devramsean0/train-locs-board/README.md

# train-locs-board
A LED train location board, meant to show the trains on platform at any station
