devramsean0/train-locs-board/Journal/images/schematic-microcontroller-v1.png

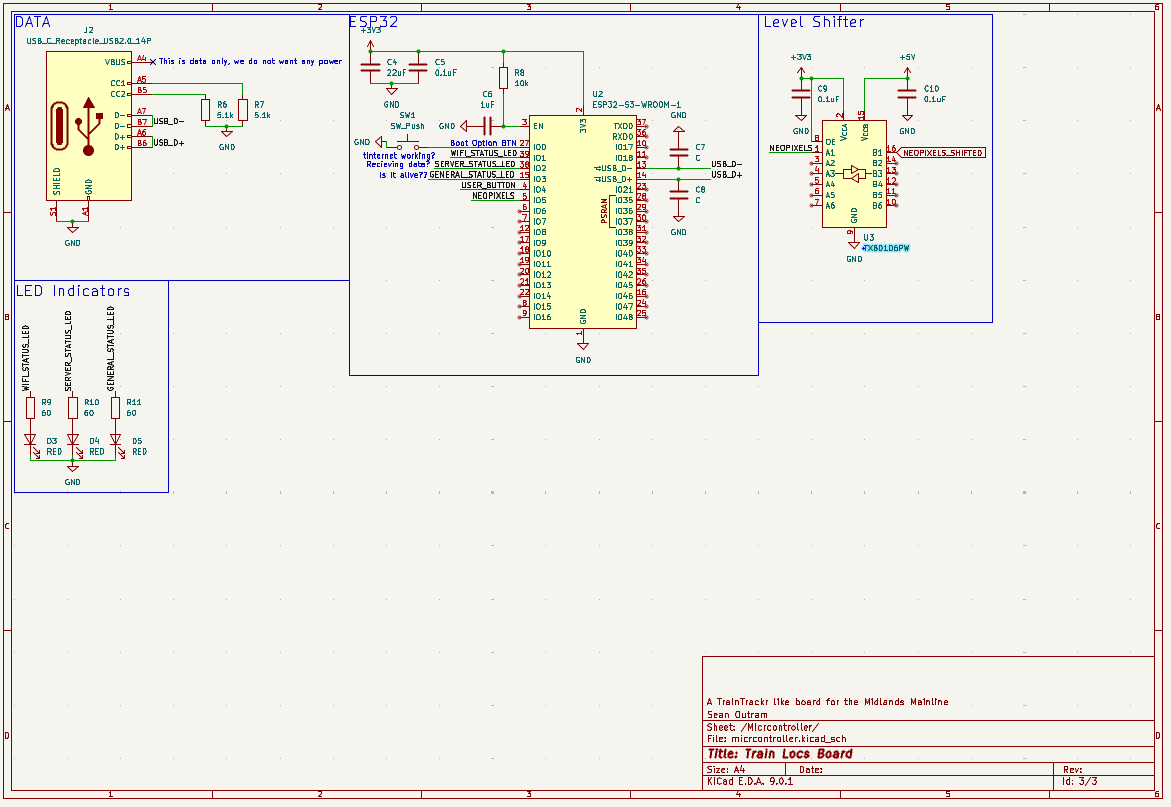
Journal/images/schematic-microcontroller-v1.png
