devramsean0/train-locs-board/Journal/images/microcontroller-reset.png

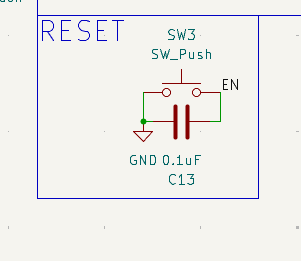
Journal/images/microcontroller-reset.png
