devramsean0/train-locs-board/board/board.kicad_pcb

## KiCad design board/board.kicad_pcb (2025-06-15)

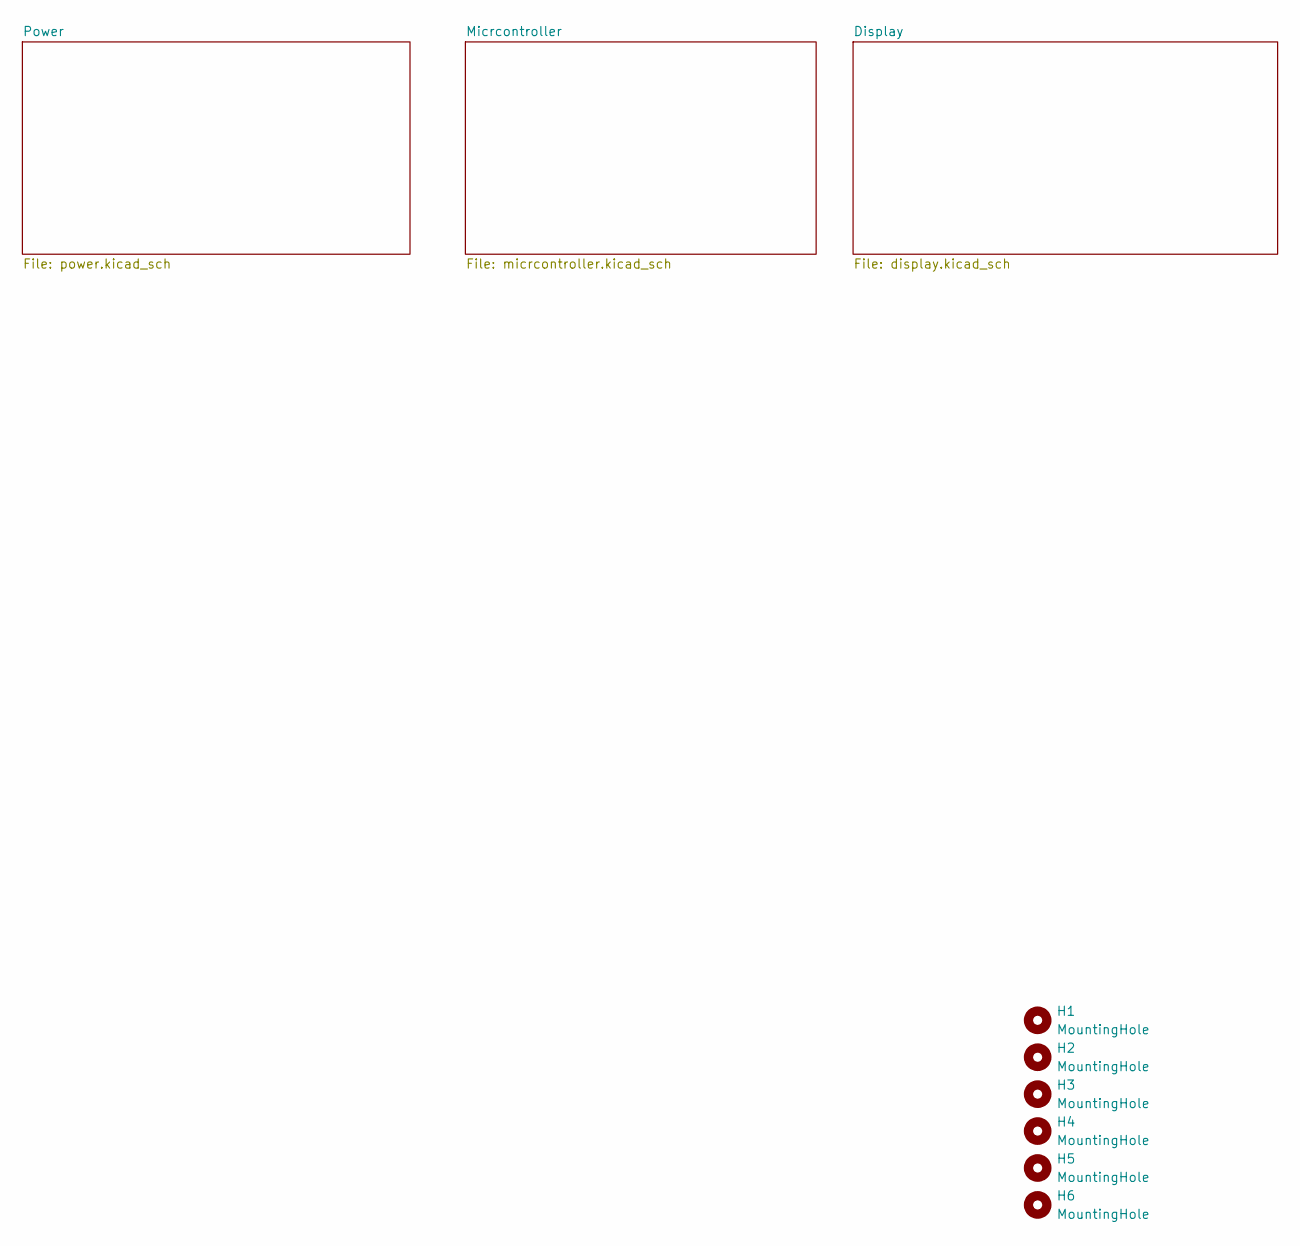
[picture p21: schematic board.kicad_sch, Train Locs Board]

Parts:
H1, H2, H3, H4, H5, H6: MountingHole; MountingHole_2.2mm_M2

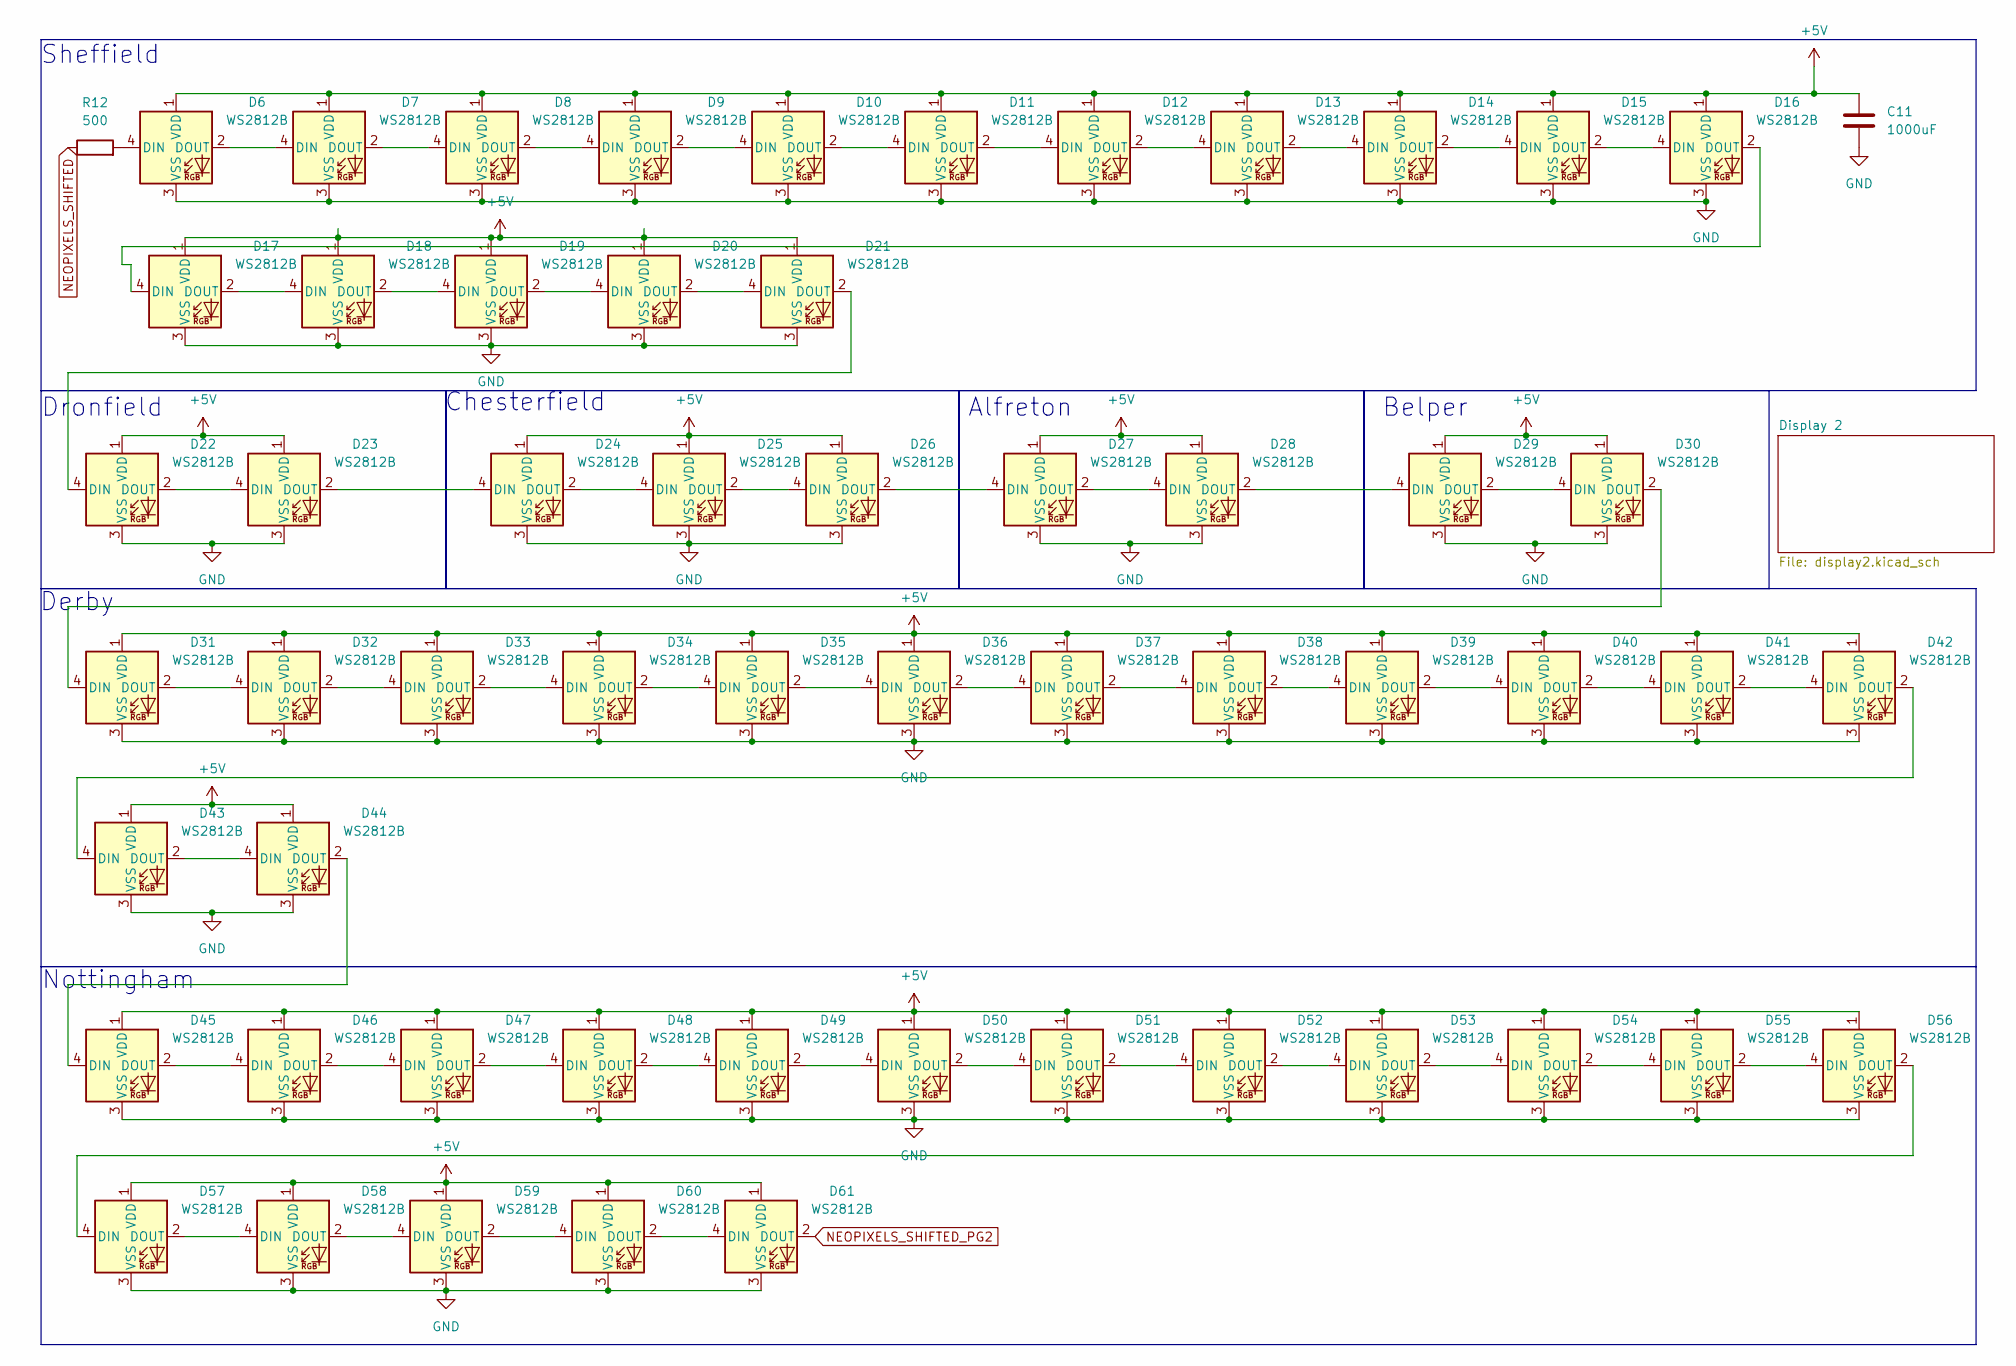
[picture p22: schematic display.kicad_sch, Train Locs Board]

Parts:
C11: 1000uF; C_0805_2012Metric
D6, D7, D8, D9, D10, D11, D12, D13, D14, D15, D16, D17, D18, D19, D20, D21, D22, D23, D24, D25, D26, D27, D28, D29, D30, D31, D32, D33, D34, D35, D36, D37, D38, D39, D40, D41, D42, D43, D44, D45, D46, D47, D48, D49, D50, D51, D52, D53, D54, D55, D56, D57, D58, D59, D60, D61: WS2812B; LED_WS2812B_PLCC4_5.0x5.0mm_P3.2mm
R12: 500; R_0805_2012Metric

Connections:
+5V: C11.1, D6.1 (VDD), D7.1 (VDD), D8.1 (VDD), D9.1 (VDD), D10.1 (VDD), D11.1 (VDD), D12.1 (VDD), D13.1 (VDD), D14.1 (VDD), D15.1 (VDD), D16.1 (VDD), D17.1 (VDD), D18.1 (VDD), D19.1 (VDD), D20.1 (VDD), D21.1 (VDD), D22.1 (VDD), D23.1 (VDD), D24.1 (VDD), D25.1 (VDD), D26.1 (VDD), D27.1 (VDD), D28.1 (VDD), D29.1 (VDD), D30.1 (VDD), D31.1 (VDD), D32.1 (VDD), D33.1 (VDD), D34.1 (VDD), D35.1 (VDD), D36.1 (VDD), D37.1 (VDD), D38.1 (VDD), D39.1 (VDD), D40.1 (VDD), D41.1 (VDD), D42.1 (VDD), D43.1 (VDD), D44.1 (VDD), D45.1 (VDD), D46.1 (VDD), D47.1 (VDD), D48.1 (VDD), D49.1 (VDD), D50.1 (VDD), D51.1 (VDD), D52.1 (VDD), D53.1 (VDD), D54.1 (VDD), D55.1 (VDD), D56.1 (VDD), D57.1 (VDD), D58.1 (VDD), D59.1 (VDD), D60.1 (VDD), D61.1 (VDD); also elsewhere on the board
GND: C11.2, D6.3 (VSS), D7.3 (VSS), D8.3 (VSS), D9.3 (VSS), D10.3 (VSS), D11.3 (VSS), D12.3 (VSS), D13.3 (VSS), D14.3 (VSS), D15.3 (VSS), D16.3 (VSS), D17.3 (VSS), D18.3 (VSS), D19.3 (VSS), D20.3 (VSS), D21.3 (VSS), D22.3 (VSS), D23.3 (VSS), D24.3 (VSS), D25.3 (VSS), D26.3 (VSS), D27.3 (VSS), D28.3 (VSS), D29.3 (VSS), D30.3 (VSS), D31.3 (VSS), D32.3 (VSS), D33.3 (VSS), D34.3 (VSS), D35.3 (VSS), D36.3 (VSS), D37.3 (VSS), D38.3 (VSS), D39.3 (VSS), D40.3 (VSS), D41.3 (VSS), D42.3 (VSS), D43.3 (VSS), D44.3 (VSS), D45.3 (VSS), D46.3 (VSS), D47.3 (VSS), D48.3 (VSS), D49.3 (VSS), D50.3 (VSS), D51.3 (VSS), D52.3 (VSS), D53.3 (VSS), D54.3 (VSS), D55.3 (VSS), D56.3 (VSS), D57.3 (VSS), D58.3 (VSS), D59.3 (VSS), D60.3 (VSS), D61.3 (VSS); also elsewhere on the board
NEOPIXELS_SHIFTED: R12.1; also elsewhere on the board
NEOPIXELS_SHIFTED_PG2: D61.2 (DOUT); also elsewhere on the board
unnamed: D6.4 (DIN), R12.2
unnamed: D6.2 (DOUT), D7.4 (DIN)
unnamed: D7.2 (DOUT), D8.4 (DIN)
unnamed: D8.2 (DOUT), D9.4 (DIN)
unnamed: D9.2 (DOUT), D10.4 (DIN)
unnamed: D10.2 (DOUT), D11.4 (DIN)
unnamed: D11.2 (DOUT), D12.4 (DIN)
unnamed: D12.2 (DOUT), D13.4 (DIN)
unnamed: D13.2 (DOUT), D14.4 (DIN)
unnamed: D14.2 (DOUT), D15.4 (DIN)
unnamed: D15.2 (DOUT), D16.4 (DIN)
unnamed: D16.2 (DOUT), D17.4 (DIN)
unnamed: D17.2 (DOUT), D18.4 (DIN)
unnamed: D18.2 (DOUT), D19.4 (DIN)
unnamed: D19.2 (DOUT), D20.4 (DIN)
unnamed: D20.2 (DOUT), D21.4 (DIN)
unnamed: D21.2 (DOUT), D22.4 (DIN)
unnamed: D22.2 (DOUT), D23.4 (DIN)
unnamed: D23.2 (DOUT), D24.4 (DIN)
unnamed: D24.2 (DOUT), D25.4 (DIN)
unnamed: D25.2 (DOUT), D26.4 (DIN)
unnamed: D26.2 (DOUT), D27.4 (DIN)
unnamed: D27.2 (DOUT), D28.4 (DIN)
unnamed: D28.2 (DOUT), D29.4 (DIN)
unnamed: D29.2 (DOUT), D30.4 (DIN)
unnamed: D30.2 (DOUT), D31.4 (DIN)
unnamed: D31.2 (DOUT), D32.4 (DIN)
unnamed: D32.2 (DOUT), D33.4 (DIN)
unnamed: D33.2 (DOUT), D34.4 (DIN)
unnamed: D34.2 (DOUT), D35.4 (DIN)
unnamed: D35.2 (DOUT), D36.4 (DIN)
unnamed: D36.2 (DOUT), D37.4 (DIN)
unnamed: D37.2 (DOUT), D38.4 (DIN)
unnamed: D38.2 (DOUT), D39.4 (DIN)
unnamed: D39.2 (DOUT), D40.4 (DIN)
unnamed: D40.2 (DOUT), D41.4 (DIN)
unnamed: D41.2 (DOUT), D42.4 (DIN)
unnamed: D42.2 (DOUT), D43.4 (DIN)
unnamed: D43.2 (DOUT), D44.4 (DIN)
unnamed: D44.2 (DOUT), D45.4 (DIN)
unnamed: D45.2 (DOUT), D46.4 (DIN)
unnamed: D46.2 (DOUT), D47.4 (DIN)
unnamed: D47.2 (DOUT), D48.4 (DIN)
unnamed: D48.2 (DOUT), D49.4 (DIN)
unnamed: D49.2 (DOUT), D50.4 (DIN)
unnamed: D50.2 (DOUT), D51.4 (DIN)
unnamed: D51.2 (DOUT), D52.4 (DIN)
unnamed: D52.2 (DOUT), D53.4 (DIN)
unnamed: D53.2 (DOUT), D54.4 (DIN)
unnamed: D54.2 (DOUT), D55.4 (DIN)
unnamed: D55.2 (DOUT), D56.4 (DIN)
unnamed: D56.2 (DOUT), D57.4 (DIN)
unnamed: D57.2 (DOUT), D58.4 (DIN)
unnamed: D58.2 (DOUT), D59.4 (DIN)
unnamed: D59.2 (DOUT), D60.4 (DIN)
unnamed: D60.2 (DOUT), D61.4 (DIN)

Notes on the sheet:
Alfreton
Dronfield
Chesterfield
Nottingham
Sheffield
Derby
Belper

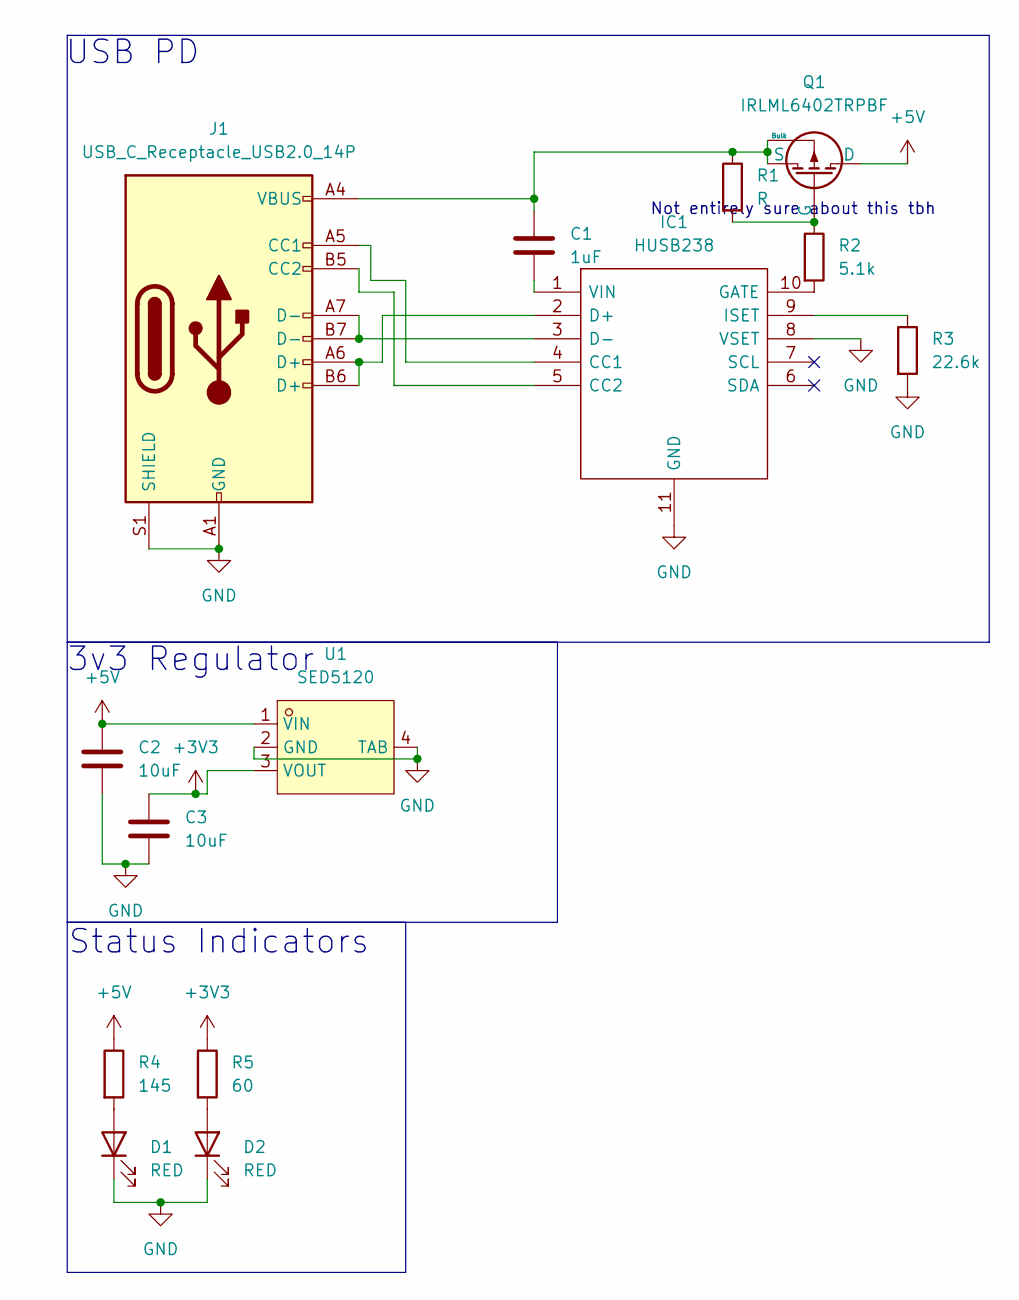
[picture p23: schematic power.kicad_sch, Train Locs Board]

Parts:
C1: 1uF; C_0805_2012Metric
C2, C3: 10uF; C_0805_2012Metric
D1, D2: RED; LED_0805_2012Metric
IC1: HUSB238; SON50P300X300X80-11N-D; Manufacturer_Part_Number HUSB238
J1: USB_C_Receptacle_USB2.0_14P; USB_C_Receptacle_G-Switch_GT-USB-7010ASV; LCSC Part C2988369
Q1: IRLML6402TRPBF; SOT-23-3_L2.9-W1.6-P1.90-LS2.8-BR
R1: R; R_0805_2012Metric
R2: 5.1k; R_0805_2012Metric
R3: 22.6k; R_0805_2012Metric
R4: 145; R_0805_2012Metric
R5: 60; R_0805_2012Metric
U1: SED5120; SOT-223-3_L6.5-W3.4-P2.30-LS7.0-BR; LCSC Part C2838439

Connections:
+3V3: C3.1, R5.1, U1.3 (VOUT); also elsewhere on the board
+5V: C2.1, Q1.1 (D), R4.1, U1.1 (VIN); also elsewhere on the board
GND: C2.2, C3.2, D1.1 (K), D2.1 (K), IC1.8 (VSET), IC1.11 (GND), J1.A1 (GND), J1.A12 (GND), J1.B1 (GND), J1.B12 (GND), J1.S1 (SHIELD), R3.2, U1.2 (GND), U1.4 (TAB); also elsewhere on the board
unnamed 13: D1.2 (A), R4.2; also elsewhere on the board
unnamed 14: D2.2 (A), R5.2; also elsewhere on the board
unnamed: IC1.4 (CC1), J1.A5 (CC1)
unnamed: IC1.5 (CC2), J1.B5 (CC2)
unnamed: IC1.2 (D+), J1.A6 (D+), J1.B6 (D+)
unnamed: IC1.3 (D-), J1.A7 (D-), J1.B7 (D-)
unnamed: IC1.10 (GATE), R2.2
unnamed: IC1.9 (ISET), R3.1
unnamed: C1.2, IC1.1 (VIN)
unnamed: C1.1, J1.A4 (VBUS), J1.A9 (VBUS), J1.B4 (VBUS), J1.B9 (VBUS), Q1.3 (S), Q1.4 (Bulk), R1.1
unnamed: Q1.2 (G), R1.2, R2.1

Notes on the sheet:
Status Indicators
Not entirely sure about this tbh
USB PD
3v3 Regulator

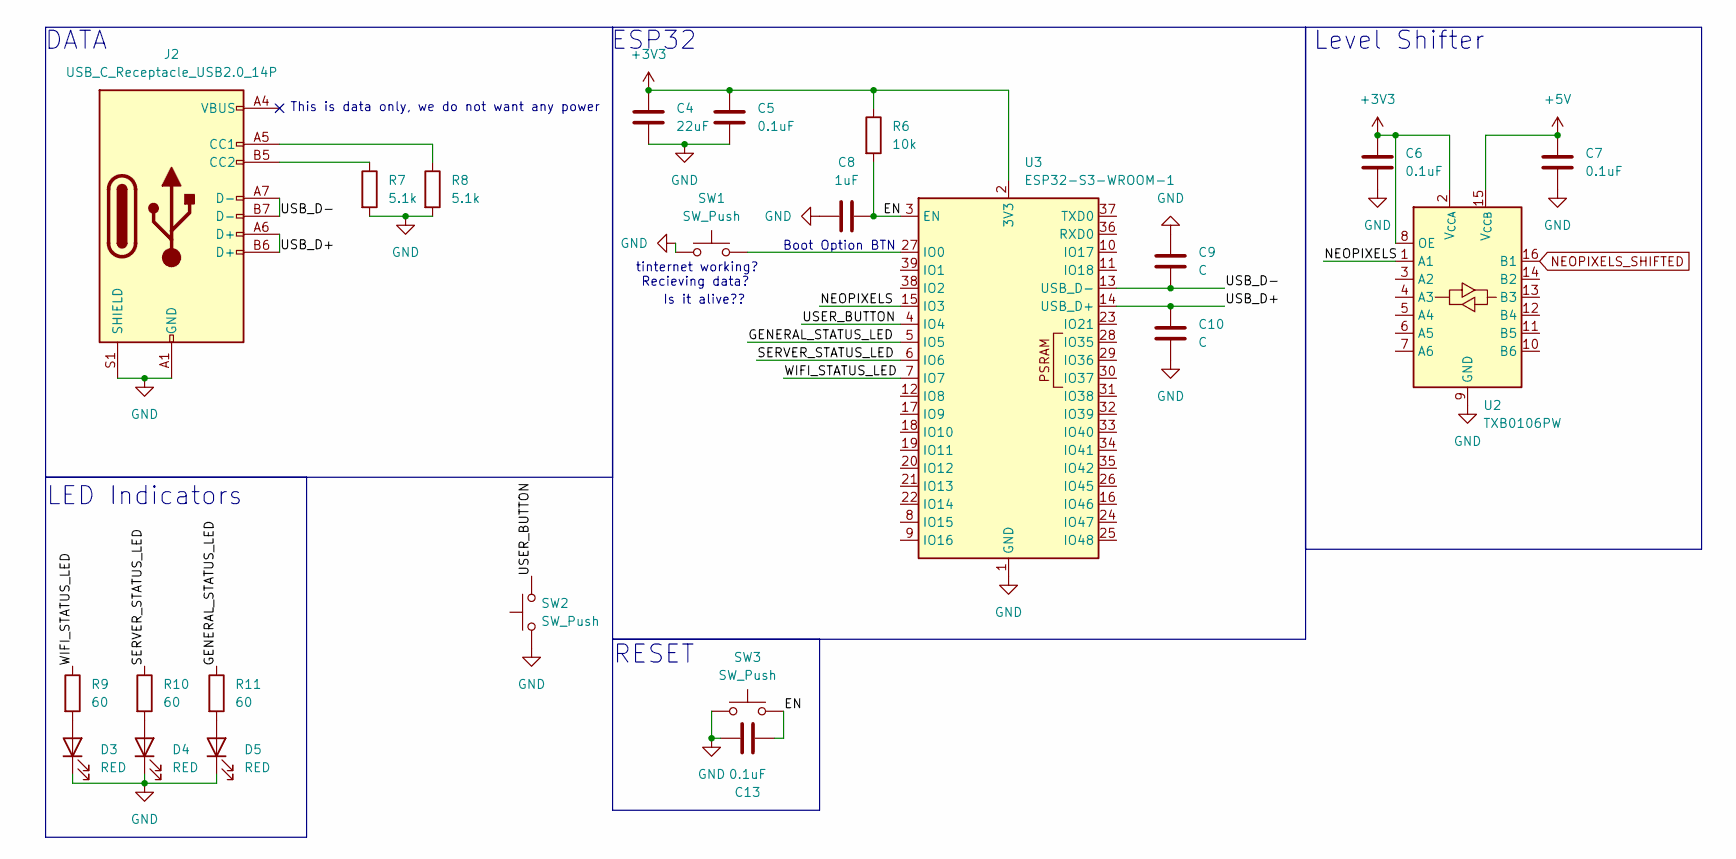
[picture p24: schematic micrcontroller.kicad_sch, Train Locs Board]

Parts:
C4: 22uF; C_0805_2012Metric
C5, C6, C7, C13: 0.1uF; C_0805_2012Metric
C8: 1uF; C_0805_2012Metric
C9, C10: C; C_0805_2012Metric
D3, D4, D5: RED; LED_0805_2012Metric
J2: USB_C_Receptacle_USB2.0_14P; USB_C_Receptacle_G-Switch_GT-USB-7010ASV; LCSC Part C2988369
R6: 10k; R_0805_2012Metric
R7, R8: 5.1k; R_0805_2012Metric
R9, R10, R11: 60; R_0805_2012Metric
SW1, SW2, SW3: SW_Push; SW-SMD_4P-L4.2-W3.3-P2.15-LS5.1
U2: TXB0106PW; TSSOP-16_4.4x5mm_P0.65mm
U3: ESP32-S3-WROOM-1

Connections:
+3V3: C4.1, C5.1, C6.1, R6.1, U2.2 (V_{CCA}), U2.8 (OE), U3.2 (3V3); also elsewhere on the board
+5V: C7.1, U2.15 (V_{CCB}); also elsewhere on the board
/Micrcontroller/EN: C8.1, C13.2, R6.2, SW3.2, U3.3 (EN)
/Micrcontroller/GENERAL_STATUS_LED: R11.1, U3.5 (IO5)
/Micrcontroller/NEOPIXELS: U2.1 (A1), U3.15 (IO3)
/Micrcontroller/SERVER_STATUS_LED: R10.1, U3.6 (IO6)
/Micrcontroller/USB_D+: C10.1, J2.A6 (D+), J2.B6 (D+), U3.14 (USB_D+)
/Micrcontroller/USB_D-: C9.2, J2.A7 (D-), J2.B7 (D-), U3.13 (USB_D-)
/Micrcontroller/USER_BUTTON: SW2.2, U3.4 (IO4)
/Micrcontroller/WIFI_STATUS_LED: R9.1, U3.7 (IO7)
GND: C4.2, C5.2, C6.2, C7.2, C8.2, C9.1, C10.2, C13.1, D3.1 (K), D4.1 (K), D5.1 (K), J2.A1 (GND), J2.A12 (GND), J2.B1 (GND), J2.B12 (GND), J2.S1 (SHIELD), R7.2, R8.2, SW1.1, SW2.1, SW3.1, U2.9 (GND), U3.1 (GND), U3.40 (GND), U3.41 (GND); also elsewhere on the board
NEOPIXELS_SHIFTED: U2.16 (B1); also elsewhere on the board
unnamed 15: D3.2 (A), R9.2; also elsewhere on the board
unnamed 16: D4.2 (A), R10.2; also elsewhere on the board
unnamed 17: D5.2 (A), R11.2; also elsewhere on the board
unnamed: J2.A5 (CC1), R8.1
unnamed: J2.B5 (CC2), R7.1
unnamed: SW1.2, U3.27 (IO0)

Notes on the sheet:
RESET
Boot Option BTN
This is data only, we do not want any power
Level Shifter
Recieving data?
tinternet working?
DATA
Is it alive??
LED Indicators
ESP32

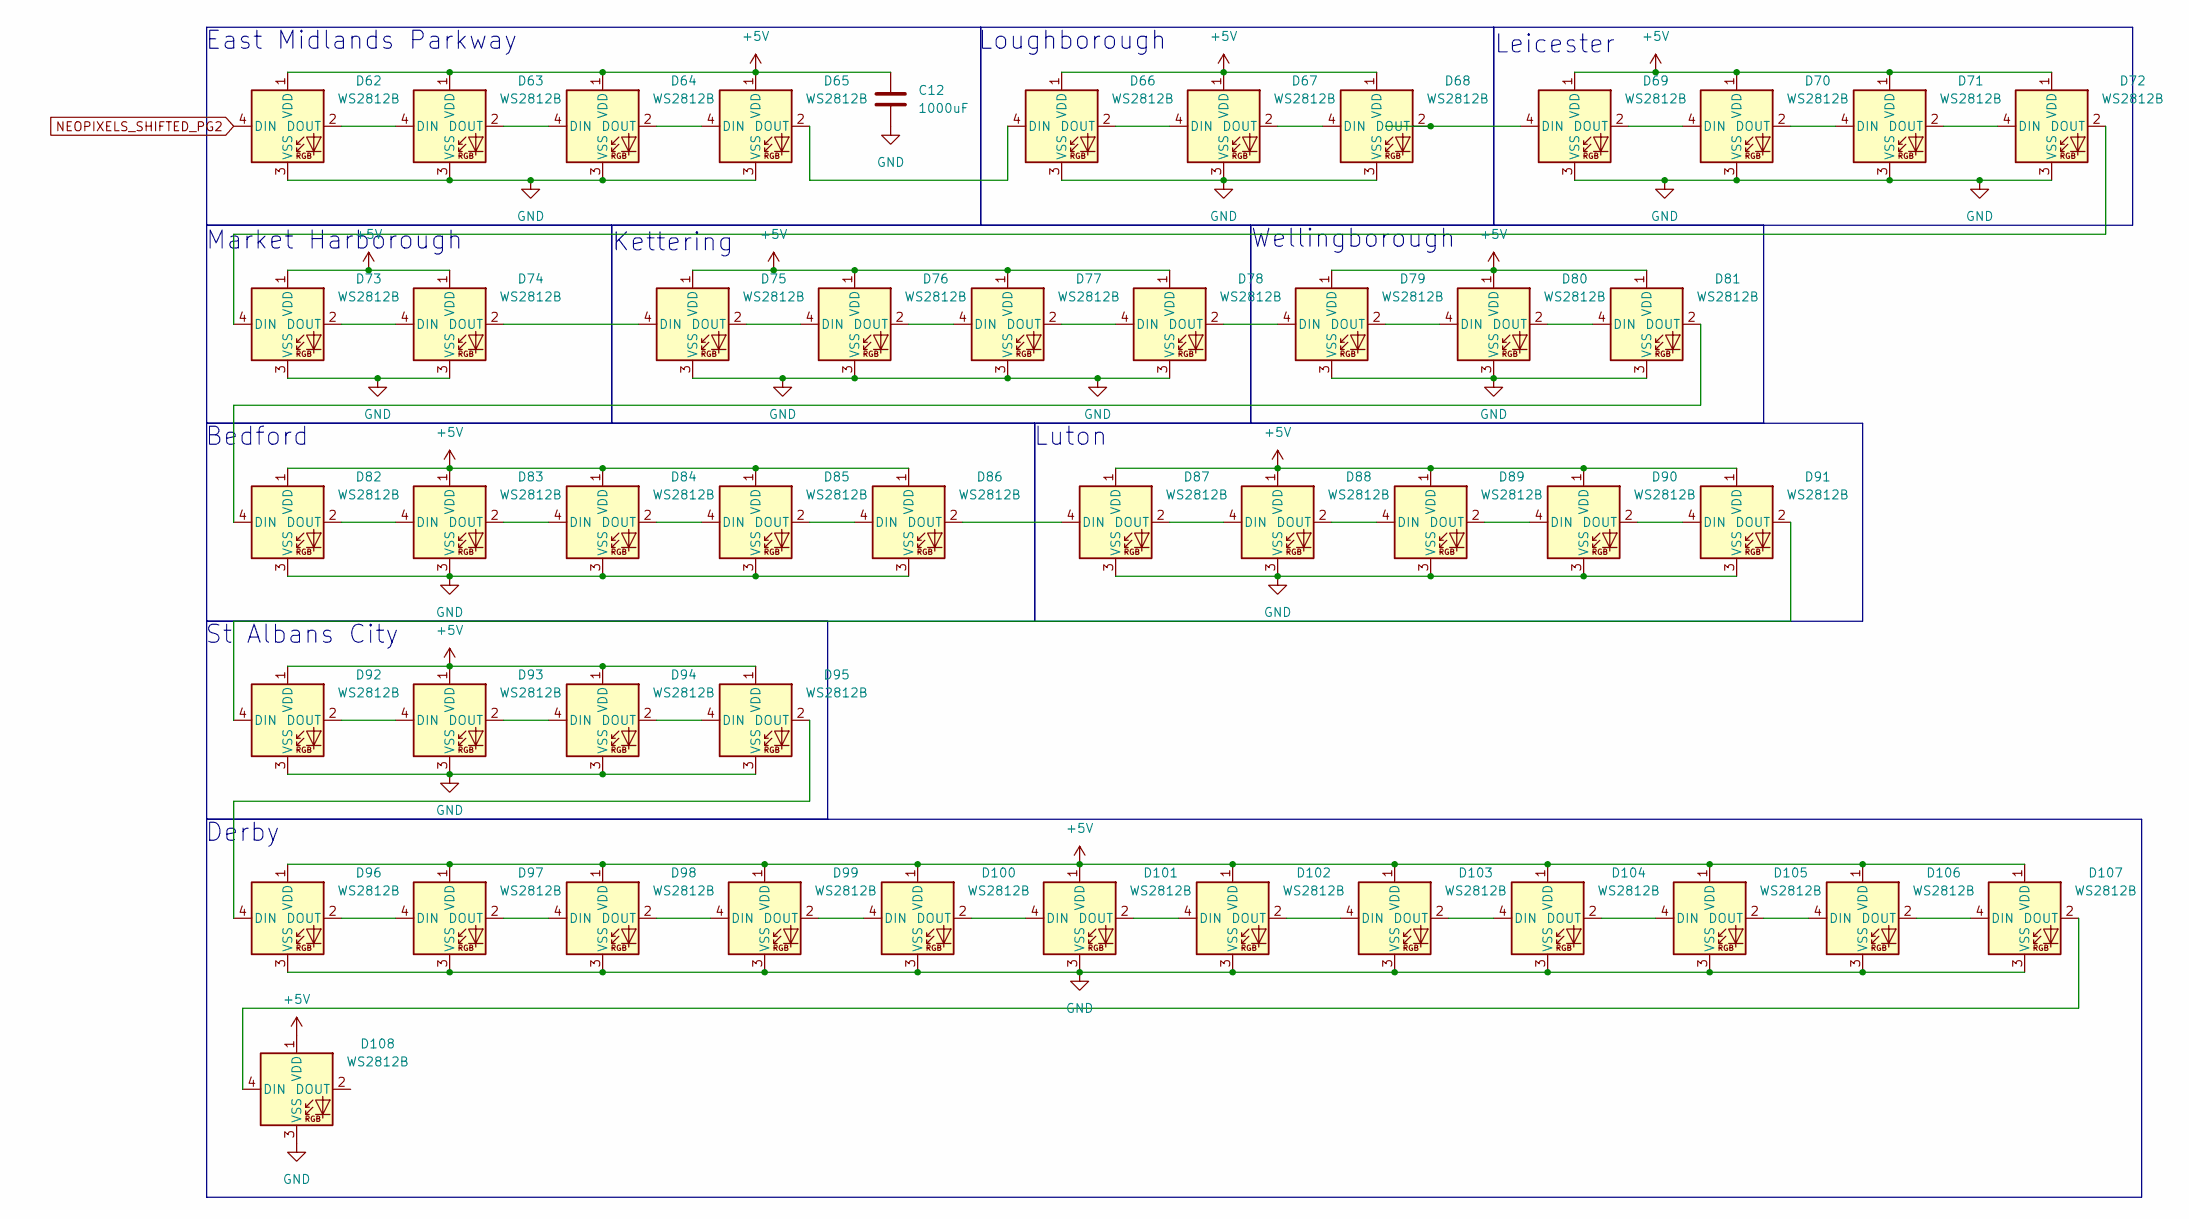
[picture p25: schematic display2.kicad_sch, Train Locs Board]

Parts:
C12: 1000uF; C_0805_2012Metric
D62, D63, D64, D65, D66, D67, D68, D69, D70, D71, D72, D73, D74, D75, D76, D77, D78, D79, D80, D81, D82, D83, D84, D85, D86, D87, D88, D89, D90, D91, D92, D93, D94, D95, D96, D97, D98, D99, D100, D101, D102, D103, D104, D105, D106, D107, D108: WS2812B; LED_WS2812B_PLCC4_5.0x5.0mm_P3.2mm

Connections:
+5V: C12.1, D62.1 (VDD), D63.1 (VDD), D64.1 (VDD), D65.1 (VDD), D66.1 (VDD), D67.1 (VDD), D68.1 (VDD), D69.1 (VDD), D70.1 (VDD), D71.1 (VDD), D72.1 (VDD), D73.1 (VDD), D74.1 (VDD), D75.1 (VDD), D76.1 (VDD), D77.1 (VDD), D78.1 (VDD), D79.1 (VDD), D80.1 (VDD), D81.1 (VDD), D82.1 (VDD), D83.1 (VDD), D84.1 (VDD), D85.1 (VDD), D86.1 (VDD), D87.1 (VDD), D88.1 (VDD), D89.1 (VDD), D90.1 (VDD), D91.1 (VDD), D92.1 (VDD), D93.1 (VDD), D94.1 (VDD), D95.1 (VDD), D96.1 (VDD), D97.1 (VDD), D98.1 (VDD), D99.1 (VDD), D100.1 (VDD), D101.1 (VDD), D102.1 (VDD), D103.1 (VDD), D104.1 (VDD), D105.1 (VDD), D106.1 (VDD), D107.1 (VDD), D108.1 (VDD); also elsewhere on the board
GND: C12.2, D62.3 (VSS), D63.3 (VSS), D64.3 (VSS), D65.3 (VSS), D66.3 (VSS), D67.3 (VSS), D68.3 (VSS), D69.3 (VSS), D70.3 (VSS), D71.3 (VSS), D72.3 (VSS), D73.3 (VSS), D74.3 (VSS), D75.3 (VSS), D76.3 (VSS), D77.3 (VSS), D78.3 (VSS), D79.3 (VSS), D80.3 (VSS), D81.3 (VSS), D82.3 (VSS), D83.3 (VSS), D84.3 (VSS), D85.3 (VSS), D86.3 (VSS), D87.3 (VSS), D88.3 (VSS), D89.3 (VSS), D90.3 (VSS), D91.3 (VSS), D92.3 (VSS), D93.3 (VSS), D94.3 (VSS), D95.3 (VSS), D96.3 (VSS), D97.3 (VSS), D98.3 (VSS), D99.3 (VSS), D100.3 (VSS), D101.3 (VSS), D102.3 (VSS), D103.3 (VSS), D104.3 (VSS), D105.3 (VSS), D106.3 (VSS), D107.3 (VSS), D108.3 (VSS); also elsewhere on the board
NEOPIXELS_SHIFTED_PG2: D62.4 (DIN); also elsewhere on the board
unnamed: D62.2 (DOUT), D63.4 (DIN)
unnamed: D63.2 (DOUT), D64.4 (DIN)
unnamed: D64.2 (DOUT), D65.4 (DIN)
unnamed: D65.2 (DOUT), D66.4 (DIN)
unnamed: D66.2 (DOUT), D67.4 (DIN)
unnamed: D67.2 (DOUT), D68.4 (DIN)
unnamed: D68.2 (DOUT), D69.4 (DIN)
unnamed: D69.2 (DOUT), D70.4 (DIN)
unnamed: D70.2 (DOUT), D71.4 (DIN)
unnamed: D71.2 (DOUT), D72.4 (DIN)
unnamed: D72.2 (DOUT), D73.4 (DIN)
unnamed: D73.2 (DOUT), D74.4 (DIN)
unnamed: D74.2 (DOUT), D75.4 (DIN)
unnamed: D75.2 (DOUT), D76.4 (DIN)
unnamed: D76.2 (DOUT), D77.4 (DIN)
unnamed: D77.2 (DOUT), D78.4 (DIN)
unnamed: D78.2 (DOUT), D79.4 (DIN)
unnamed: D79.2 (DOUT), D80.4 (DIN)
unnamed: D80.2 (DOUT), D81.4 (DIN)
unnamed: D81.2 (DOUT), D82.4 (DIN)
unnamed: D82.2 (DOUT), D83.4 (DIN)
unnamed: D83.2 (DOUT), D84.4 (DIN)
unnamed: D84.2 (DOUT), D85.4 (DIN)
unnamed: D85.2 (DOUT), D86.4 (DIN)
unnamed: D86.2 (DOUT), D87.4 (DIN)
unnamed: D87.2 (DOUT), D88.4 (DIN)
unnamed: D88.2 (DOUT), D89.4 (DIN)
unnamed: D89.2 (DOUT), D90.4 (DIN)
unnamed: D90.2 (DOUT), D91.4 (DIN)
unnamed: D91.2 (DOUT), D92.4 (DIN)
unnamed: D92.2 (DOUT), D93.4 (DIN)
unnamed: D93.2 (DOUT), D94.4 (DIN)
unnamed: D94.2 (DOUT), D95.4 (DIN)
unnamed: D95.2 (DOUT), D96.4 (DIN)
unnamed: D96.2 (DOUT), D97.4 (DIN)
unnamed: D97.2 (DOUT), D98.4 (DIN)
unnamed: D98.2 (DOUT), D99.4 (DIN)
unnamed: D99.2 (DOUT), D100.4 (DIN)
unnamed: D100.2 (DOUT), D101.4 (DIN)
unnamed: D101.2 (DOUT), D102.4 (DIN)
unnamed: D102.2 (DOUT), D103.4 (DIN)
unnamed: D103.2 (DOUT), D104.4 (DIN)
unnamed: D104.2 (DOUT), D105.4 (DIN)
unnamed: D105.2 (DOUT), D106.4 (DIN)
unnamed: D106.2 (DOUT), D107.4 (DIN)
unnamed: D107.2 (DOUT), D108.4 (DIN)

Notes on the sheet:
Bedford
East Midlands Parkway
Loughborough
Kettering
Luton
St Albans City
Market Harborough
Wellingborough
Leicester
Derby

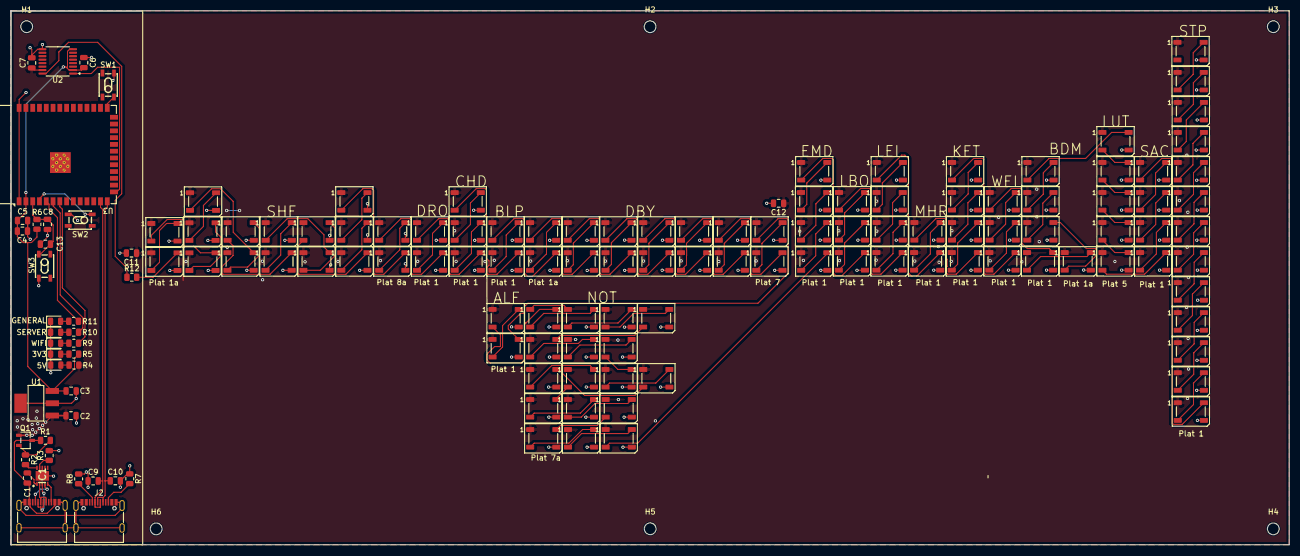
[picture p26: board board.kicad_pcb from above]

Board: 4 copper layers, 239.4 x 100.0 mm, 149 parts (0 on the bottom side), 132 nets.

Other parts of the board:
3V3, 5V: RED; LED_0805_2012Metric
GENERAL: RED; LED_0805_2012Metric
SERVER: RED; LED_0805_2012Metric
WIFI: RED; LED_0805_2012Metric

Their connections:
GND: 3V3.1 (K), 5V.1 (K), GENERAL.1 (K), SERVER.1 (K), WIFI.1 (K); also elsewhere on the board
unnamed 13: 5V.2 (A); also elsewhere on the board
unnamed 14: 3V3.2 (A); also elsewhere on the board
unnamed 15: WIFI.2 (A); also elsewhere on the board
unnamed 16: SERVER.2 (A); also elsewhere on the board
unnamed 17: GENERAL.2 (A); also elsewhere on the board
