devramsean0/train-locs-board/(commit log)

2025-06-06 We have Power
    [board.kicad_pcb, board.kicad_sch, power.kicad_sch]
2025-06-06 The microcontroller
    [board.kicad_sch, micrcontroller.kicad_sch, power.kicad_sch]
2025-06-06 Display Schematic
    [board.kicad_sch, display.kicad_sch, display2.kicad_sch, micrcontroller.kicad_sch, power.kicad_sch]
2025-06-06 Lots of silly train things
    [board.kicad_pcb, display.kicad_sch, display2.kicad_sch, micrcontroller.kicad_sch, power.kicad_sch]
2025-06-08 Micrcontroller, but wired up
    [board.kicad_pcb, micrcontroller.kicad_sch]
2025-06-08 Lay out some stations
    [board.kicad_pcb, display.kicad_sch, display2.kicad_sch]
2025-06-15 Finishing touches on the PCB
    [board.kicad_pcb, board.kicad_sch, display2.kicad_sch]
